CrematInc/CR-150-R5/README.md

# CR-150-R5
KiCad files for Cremat's CR-150-R5, an evaluation board for Cremat's charge sensitive preamplifier modules CR-11X. 
Includes a provision for wall mounted power supply.
