CrematInc/CR-150-R5/CR-150-R5-Checkplot.gif

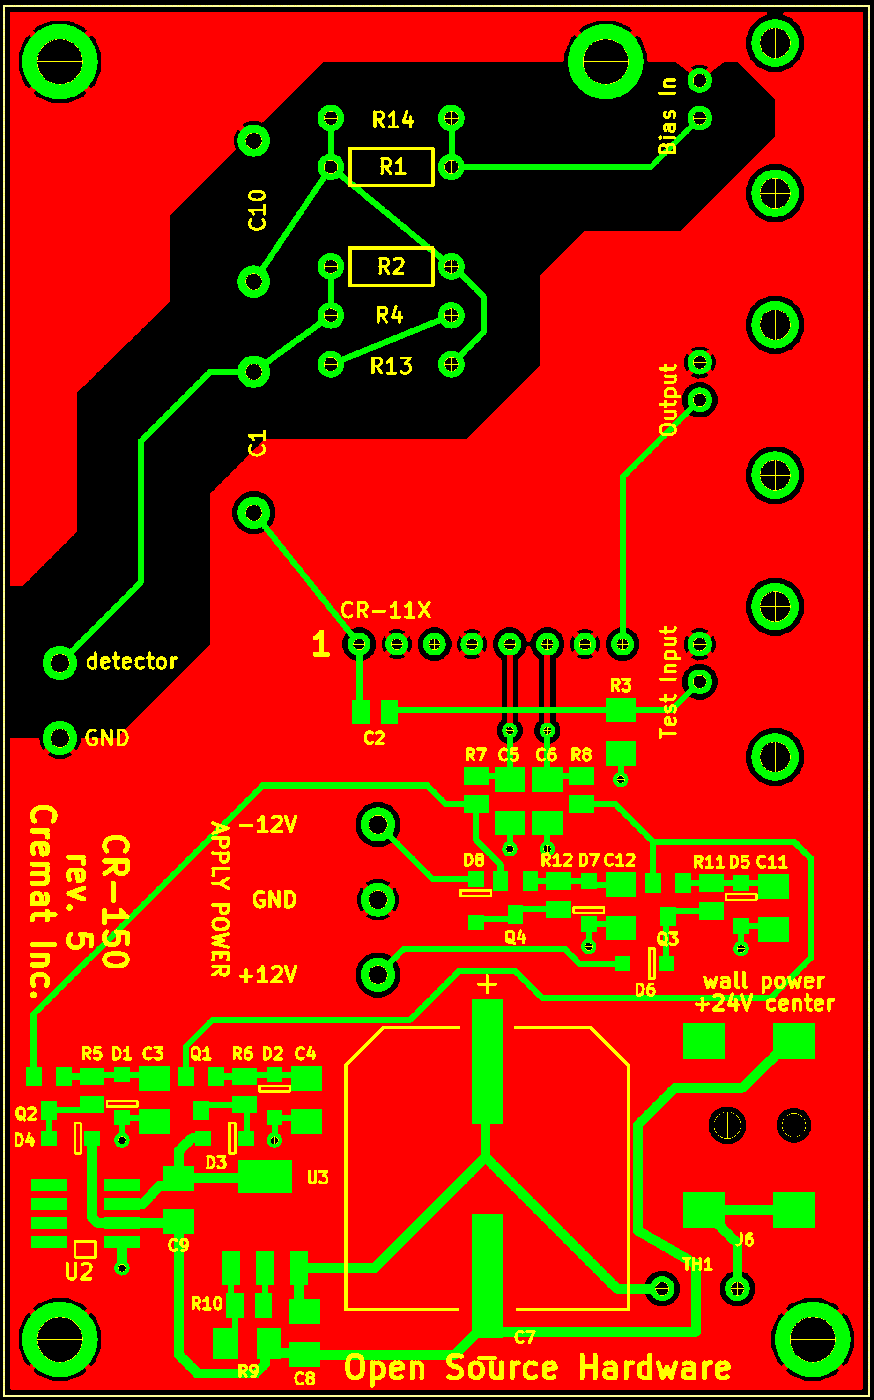
CR-150-R5-Checkplot.gif
