CrematInc/CR-150-R5/CR-150-R5 BOM.xls

Bill of Materials for CR-150-R5
line |  |  | component
number | Reference | Value | footprint | supplier | part#
1 | R3 | 47 | RES SMD 47 OHM 5% 1/4W 1206 | DigiKey | P47ECT-ND
2 | R4,R13 | 100M | Thru-Hole RES 100M OHM 1/4W 5% AXIAL | Digi-key | A105971CT-ND
3 | R5,R6,R11,R12 | 1.0k | RES SMD 1K OHM 1% 1/8W 0805 | DigiKey | RMCF0805FT1K00CT-ND
4 | R7,R8 | 4.7 | RES SMD 4.7 OHM 5% 1/8W 0805 | DigiKey | P4.7ACT-ND
5 | R9 | 4.02k | RES SMD 4.02K OHM 1% 1/4W 1206 | DigiKey | RMCF1206FT4K02CT-ND
6 | R10 | 240 | RES SMD 240 OHM 1% 1/8W 0805 | DigiKey | P240CCT-ND
7 | R14 | 10M | Thru-Hole RES 10M OHM 1/4W 5% CARBON FILM | Digi-key | CF14JT10M0CT-ND
8 | C1,C10 | 0.01uF | Ceramic Disc Capacitors .01uF 3Kvolts 20% .375LS Y5V | Mouser | 75-564R30GASS10
9 | C2 | 1pF | CAP CER 1PF 50V NPO 0805 | DigiKey | 311-1089-1-ND
10 | C3,C4,C5,C6,C8,C9,C11,C12 | 10uF ceramic | CAP CER 10UF 25V 10% X5R 1206 | DigiKey | 1276-1075-1-ND
11 | C7 | 1000uF alum | CAP ALUM 1000UF 35V 20% SMD | DigiKey | PCE3684CT-ND
12 | D1,D2,D5,D7 | 7.5V Zener diodes | DIODE ZENER 7.5V 200MW SOD323 | DigiKey | MM3Z7V5T1GOSCT-ND
13 | D3,D4,D6,D8 | 1N4148 diode | DIODE GEN PURP 75V 150MA SOD323 | DigiKey | 1N4148WXTPMSCT-ND
14 | Q1,Q3 | MMBT3904 | TRANS NPN 40V 0.2A SMD SOT23-3 | Digi-key | MMBT3904-FDITR-ND
15 | Q2,Q4 | MMBT3906 | TRANS PNP 40V 0.2A SOT23-3 | Digi-key | MMBT3906-FDITR-ND
16 | J1 | 3-terminal block | Fixed Terminal Blocks 5.0MM PCB MOUNT 3P | Mouser | 571-2828363
17 | J2,J4,J5 | boardmount BNC | BNC connector JACK PCB STD bulkhead | Mouser | 538-73138-5033
18 | J6 | Barrel connector | CONN POWER JACK 2.1X5.5MM SMT | DigiKey | CP-002AHPJCT-ND
19 | U2 | TLE2426 | IC VREF GND REF ADJ 8SOIC | DigiKey | 296-1345-1-ND
20 | U3 | LM317DCYR | IC REG LDO ADJ 1.5A SOT223 | DigiKey | 296-12602-1-ND
21 | TH1 | Inrush Current Limiter | thru-hole 22.0ohm +/-15% Thermistor-NTC | Mouser | 81-NTPA7220LBMB0
