CrematInc/CR-150-R5/CR-150-R5-schematic.pdf

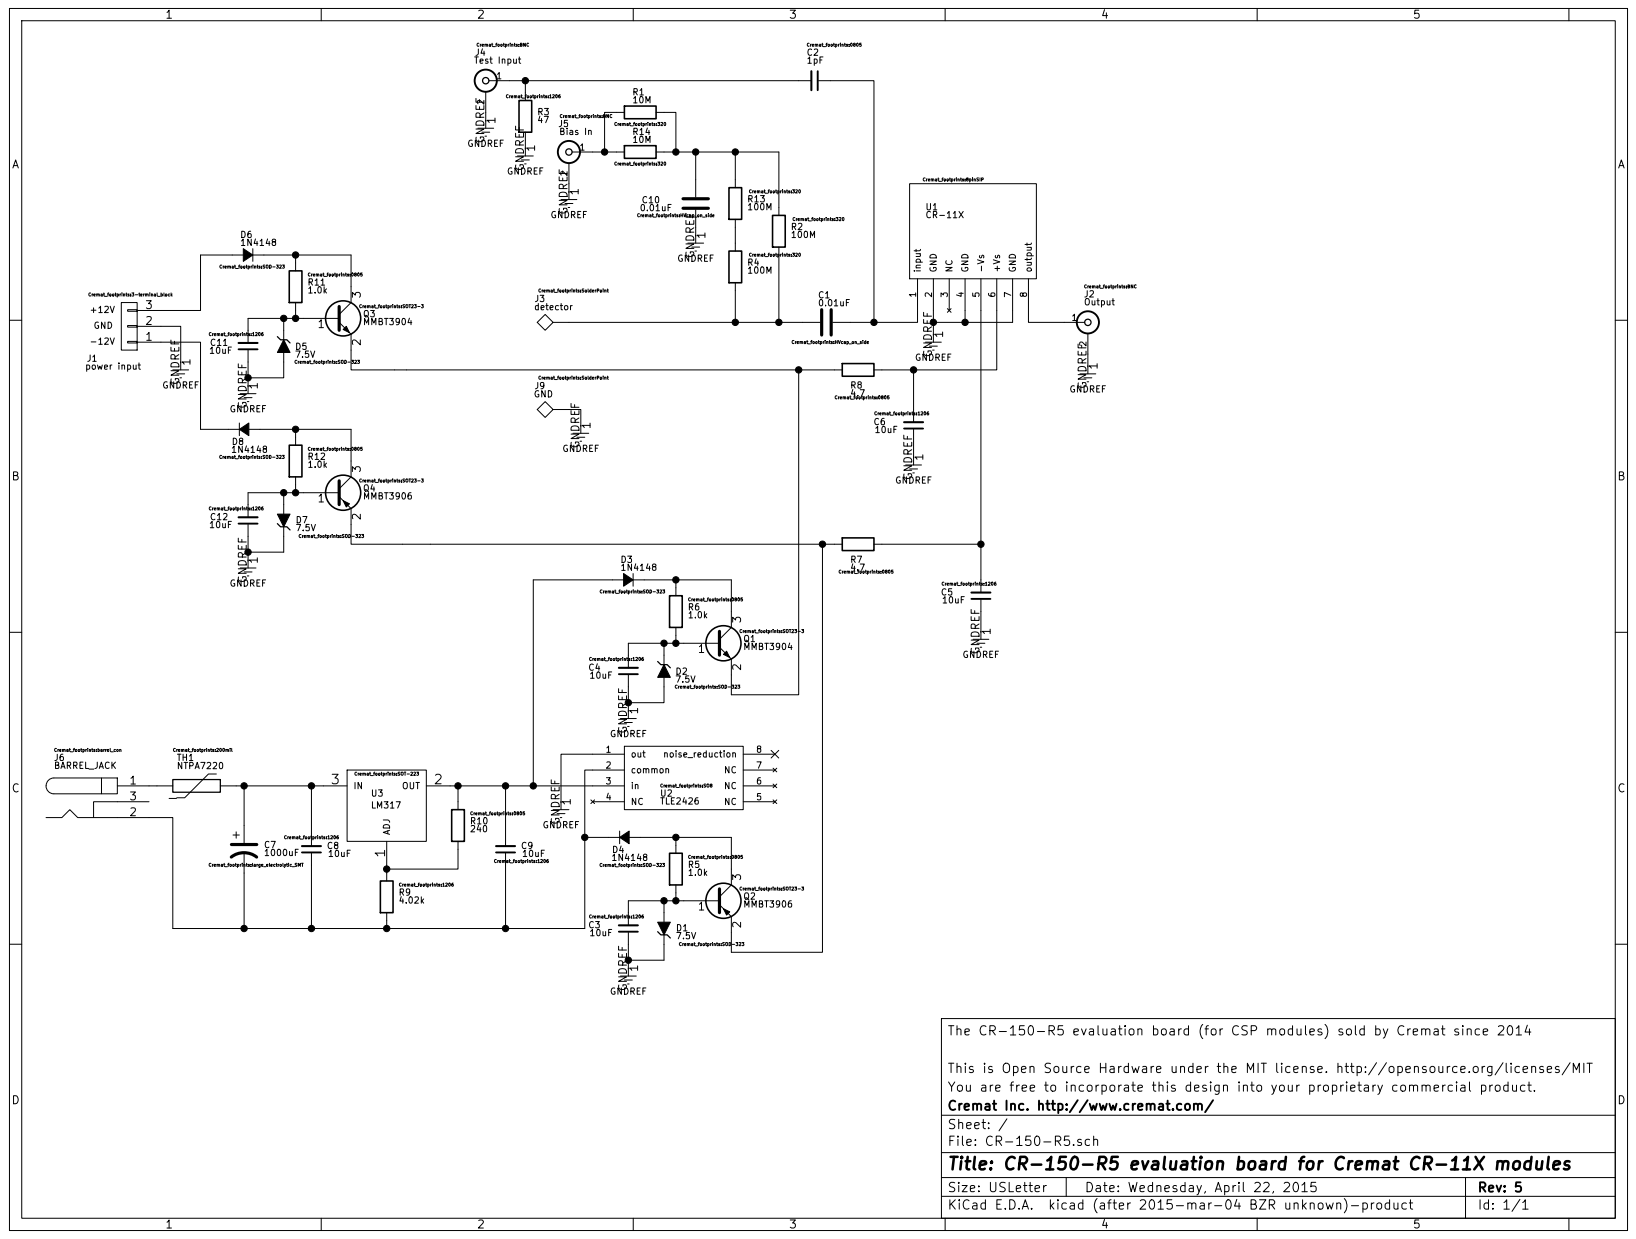
[picture p2: page 1]
