CrematInc/CR-150-R5/CR-150-R5.kicad_pcb

## KiCad design CR-150-R5.kicad_pcb (2015-11-24)

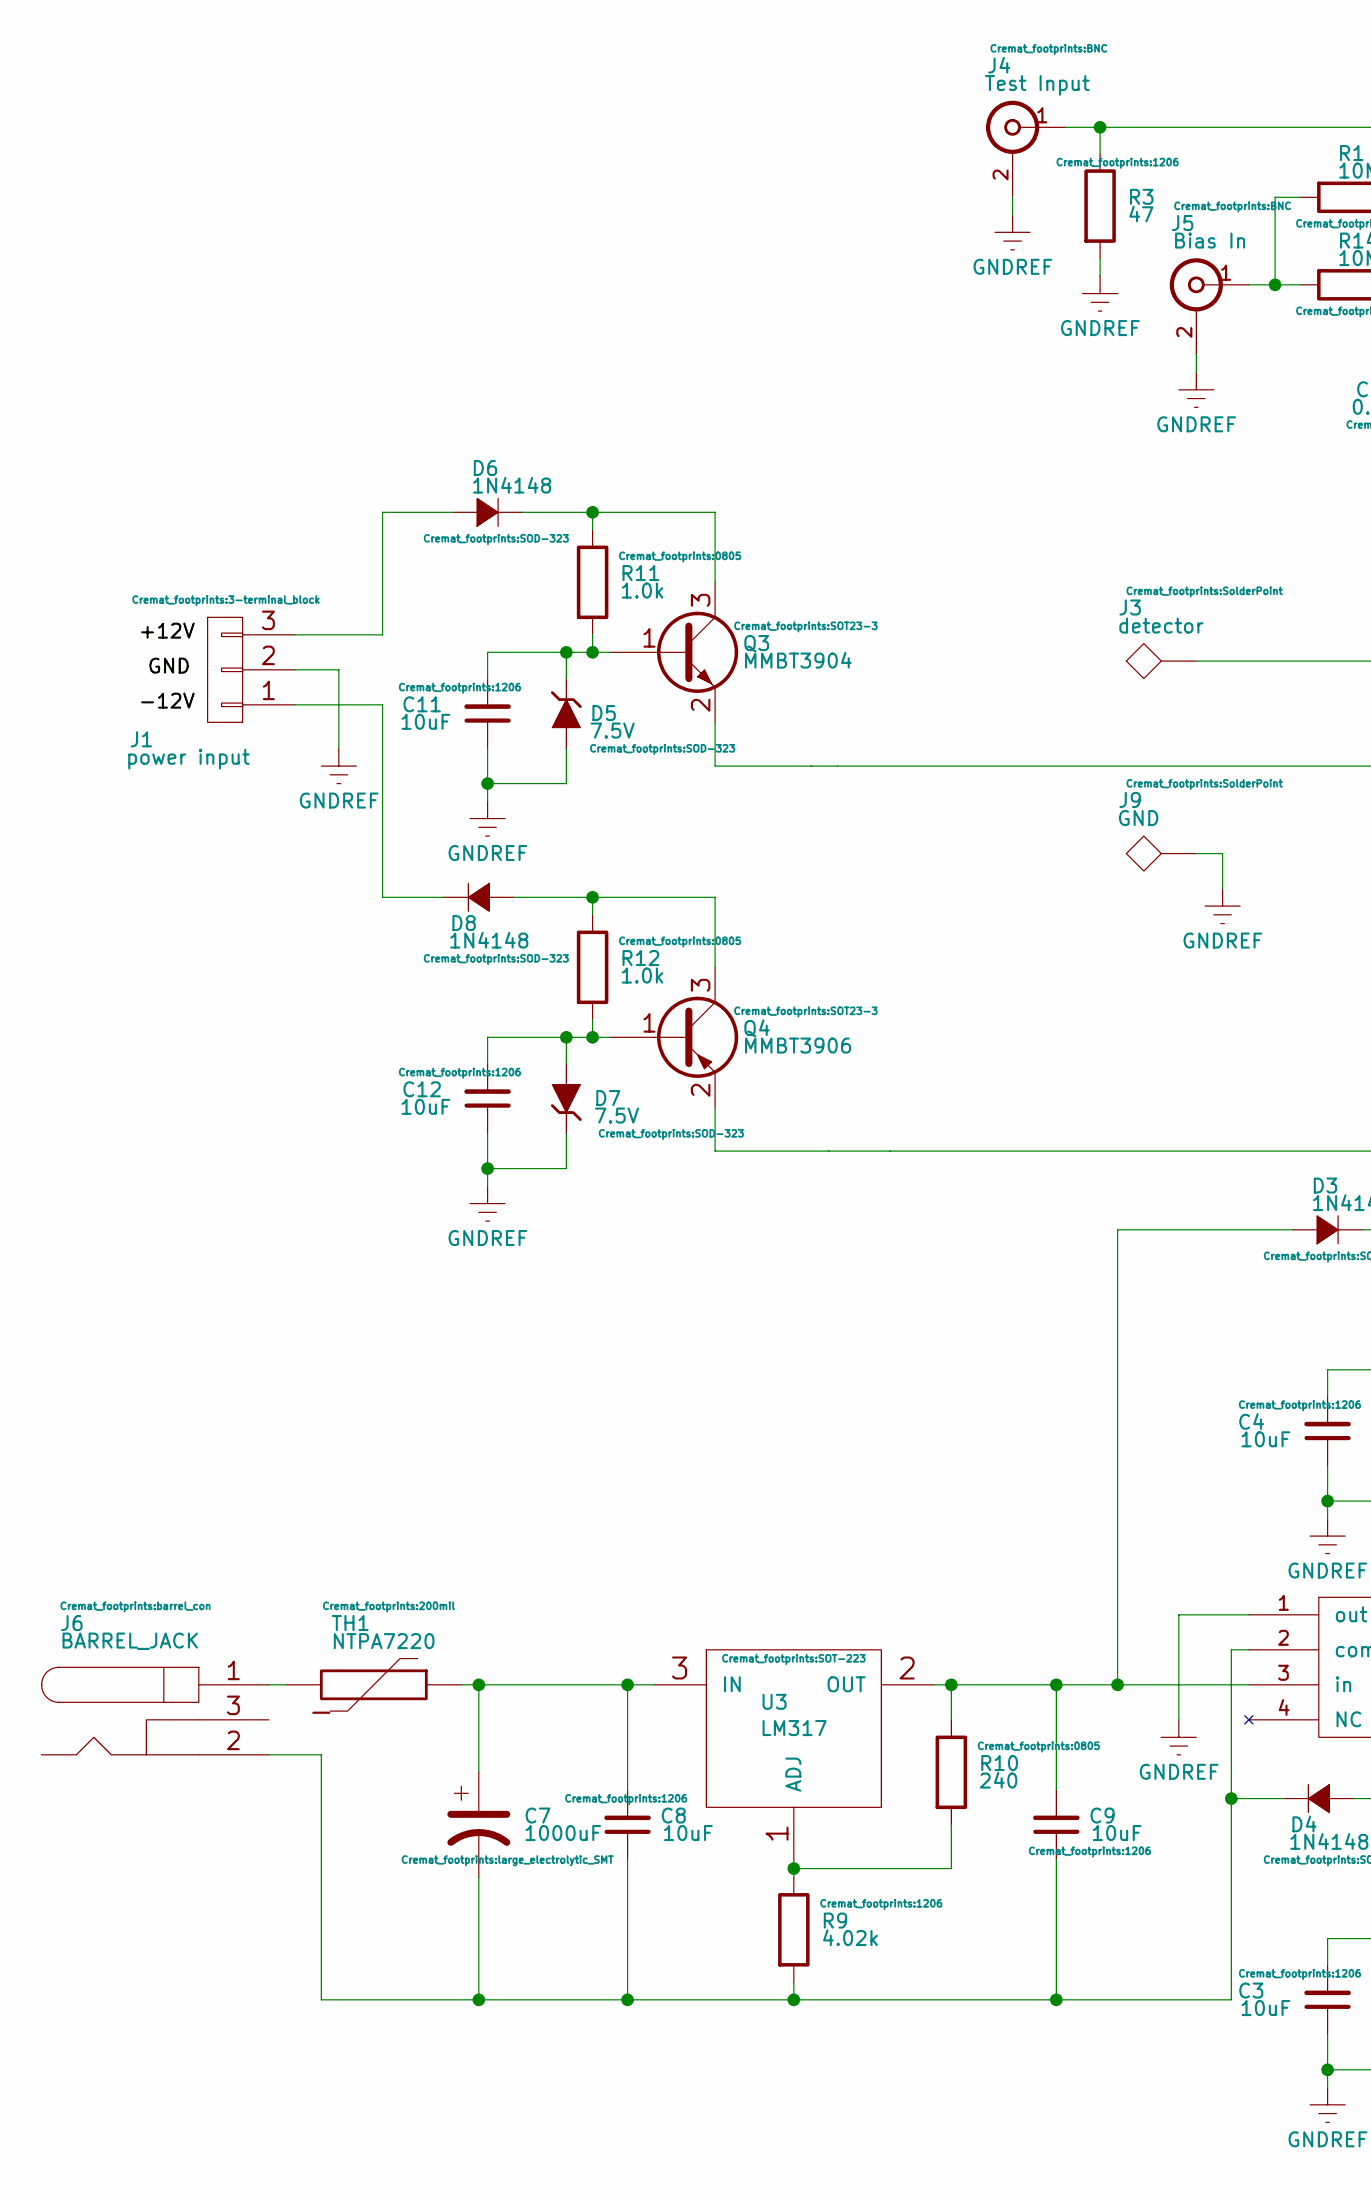
[picture p3: schematic CR-150-R5.sch, CR-150-R5 evaluation board for Cremat CR-11X modules, part in row 1, column 1]

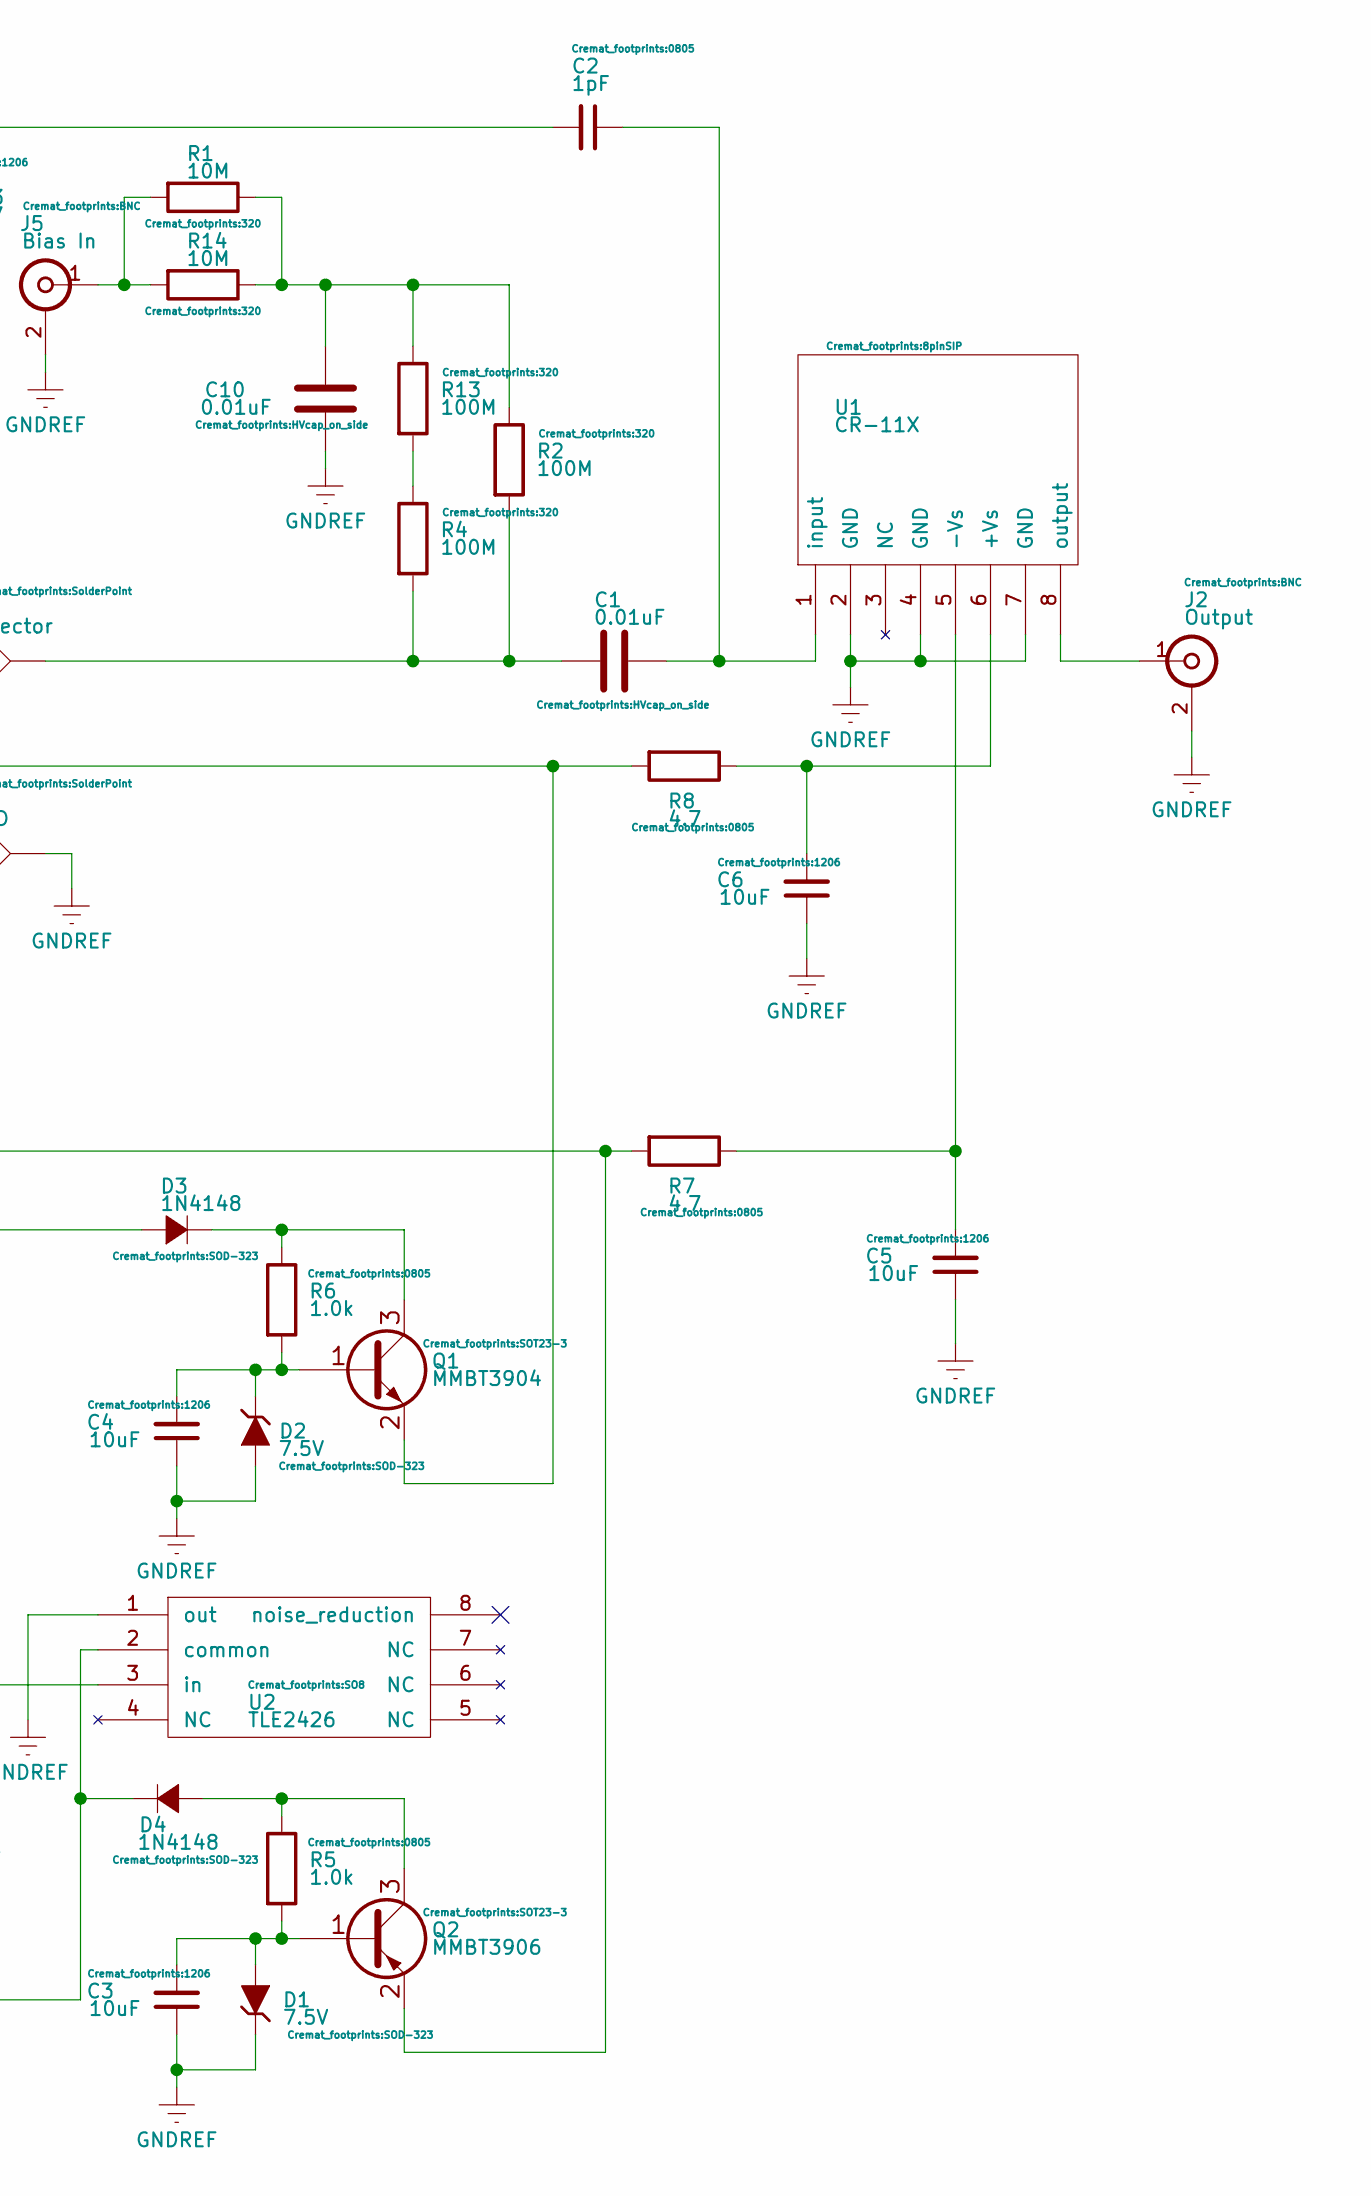
[picture p4: schematic CR-150-R5.sch, CR-150-R5 evaluation board for Cremat CR-11X modules, part in row 1, column 2]

Parts:
C1, C10: 0.01uF; HVcap_on_side
C2: 1pF; 0805
C3, C4, C5, C6, C8, C9, C11, C12: 10uF; 1206
C7: 1000uF; large_electrolytic_SMT
D1, D2, D5, D7: 7.5V; SOD-323
D3, D4, D6, D8: 1N4148; SOD-323
J1: power input; 3-terminal_block
J2: Output; BNC
J3: detector; SolderPoint
J4: Test Input; BNC
J5: Bias In; BNC
J6: BARREL_JACK; barrel_con
J9: GND; SolderPoint
Q1, Q3: MMBT3904; SOT23-3
Q2, Q4: MMBT3906; SOT23-3
R1, R14: 10M; 320
R2, R4, R13: 100M; 320
R3: 47; 1206
R5, R6, R11, R12: 1.0k; 0805
R7, R8: 4.7; 0805
R9: 4.02k; 1206
R10: 240; 0805
TH1: NTPA7220; 200mil
U1: CR-11X; 8pinSIP
U2: TLE2426; SO8
U3: LM317; SOT-223

Connections:
GNDREF: C3.1, C4.1, C5.1, C6.1, C10.1, C11.1, C12.1, D1.2 (K), D2.1 (A), D5.1 (A), D7.2 (K), J1.2, J2.2 (Ext), J4.2 (Ext), J5.2 (Ext), J9.1, R3.2, U1.2 (GND), U1.4 (GND), U1.7 (GND), U2.1 (out)
unnamed: C1.1, J3.1, R2.2, R4.2
unnamed: C1.2, C2.1, U1.1 (input)
unnamed: C2.2, J4.1 (In), R3.1
unnamed: C3.2, D1.1 (A), Q2.1 (B), R5.2
unnamed: C4.2, D2.2 (K), Q1.1 (B), R6.2
unnamed: C5.2, R7.1, U1.5 (-Vs)
unnamed: C6.2, R8.1, U1.6 (+Vs)
unnamed: C7.1, C8.2, TH1.1, U3.3 (IN)
unnamed: C7.2, C8.1, C9.1, D4.2 (C), J6.2, R9.2, U2.2 (common)
unnamed: C9.2, D3.1 (A), R10.1, U2.3 (in), U3.2 (OUT)
unnamed: C10.2, R1.1, R2.1, R13.1, R14.1
unnamed: C11.2, D5.2 (K), Q3.1 (B), R11.2
unnamed: C12.2, D7.1 (A), Q4.1 (B), R12.2
unnamed: D3.2 (C), Q1.3 (C), R6.1
unnamed: D4.1 (A), Q2.3 (C), R5.1
unnamed: D6.1 (A), J1.3
unnamed: D6.2 (C), Q3.3 (C), R11.1
unnamed: D8.1 (A), Q4.3 (C), R12.1
unnamed: D8.2 (C), J1.1
unnamed: J2.1 (In), U1.8 (output)
unnamed: J5.1 (In), R1.2, R14.2
unnamed: J6.1, TH1.2
unnamed: Q1.2 (E), Q3.2 (E), R8.2
unnamed: Q2.2 (E), Q4.2 (E), R7.2
unnamed: R9.1, R10.2, U3.1 (ADJ)
unnamed: R4.1, R13.2

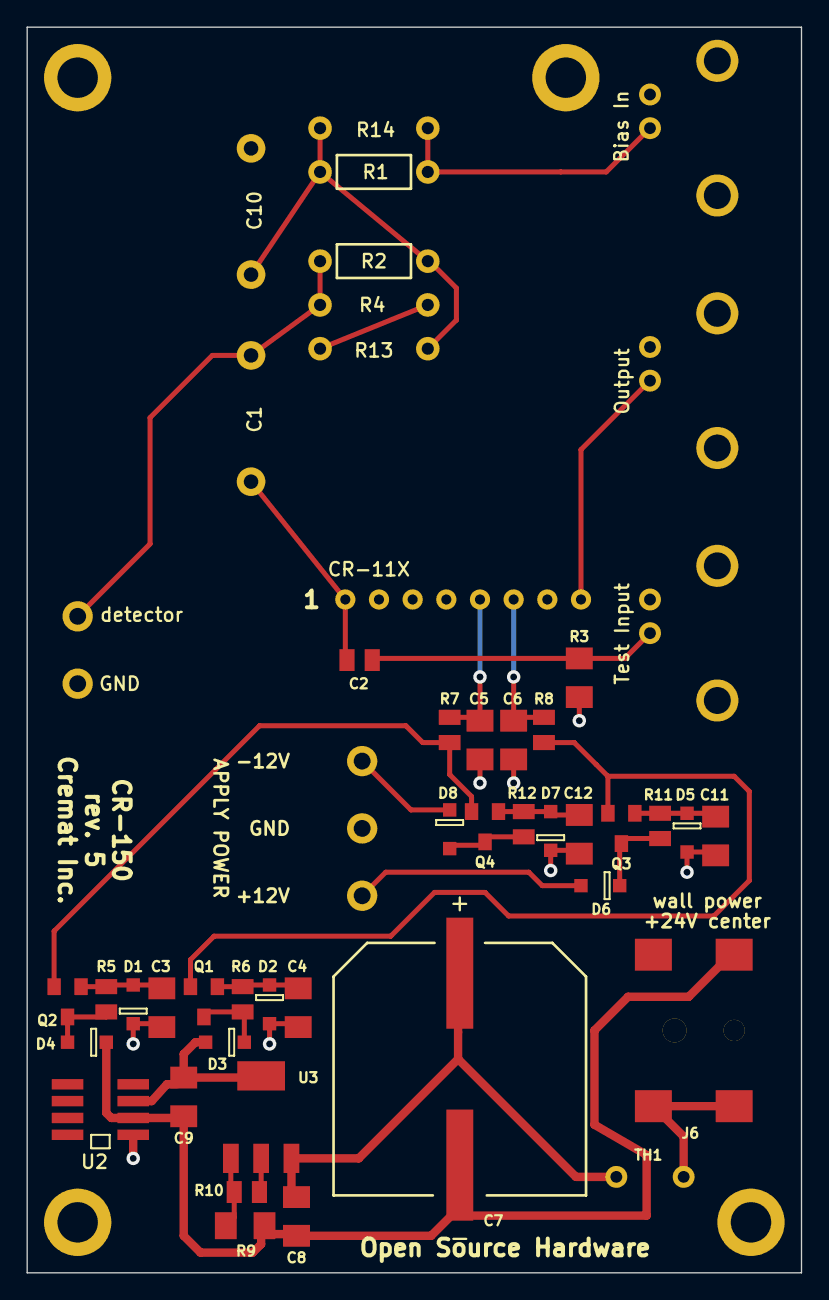
[picture p5: board CR-150-R5.kicad_pcb from above]

Board: 2 copper layers, 58.4 x 94.0 mm, 49 parts (0 on the bottom side), 27 nets.
