CrematInc/CR-150-R5/(notices)

Notices in the files:
CR-150-R5.sch:
This is Open Source Hardware under the MIT license. http://opensource.org/licenses/MIT
